konrad-bode/SummerSchool_25/SummerSchool_25.kicad_pcb

## KiCad design SummerSchool_25.kicad_pcb (2026-11-02)

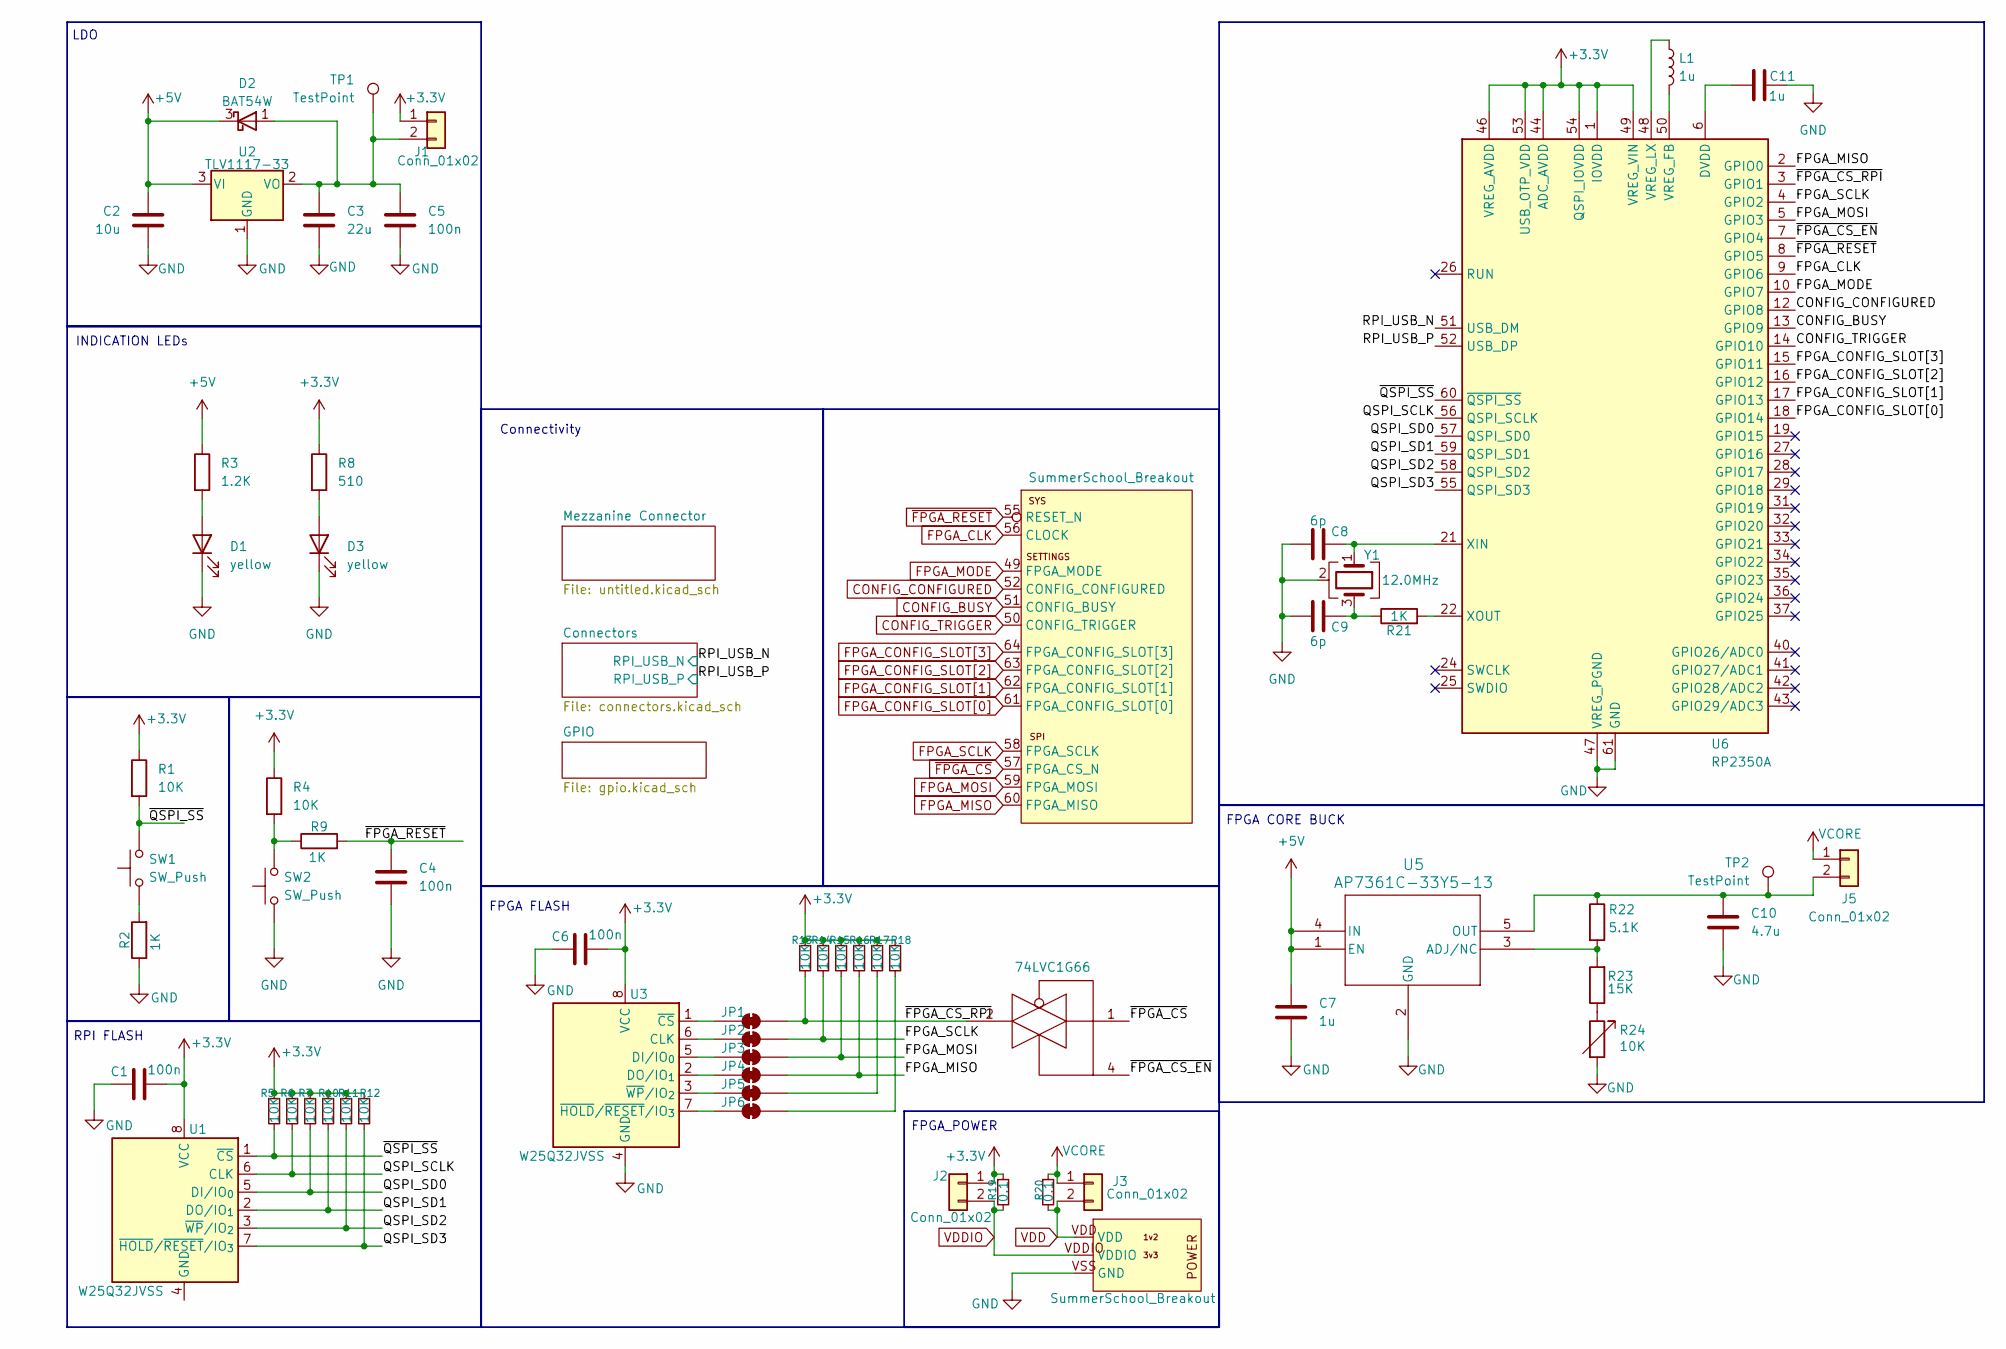
[picture p1: schematic SummerSchool_25.kicad_sch]

Parts:
C1, C4, C5, C6: 100n; C_0603_1608Metric
C2: 10u; C_0603_1608Metric
C3: 22u; C_0603_1608Metric
C7, C11: 1u; C_0603_1608Metric
C8, C9: 6p; C_0603_1608Metric
C10: 4.7u; C_0603_1608Metric
D1, D3: yellow; LED_0603_1608Metric
D2: BAT54W; SOT-323_SC-70
J1, J2, J3, J5: Conn_01x02; PinHeader_1x02_P2.54mm_Vertical
J4: SummerSchool_Breakout; SummerSchool_WireBond
JP1, JP2, JP3, JP4, JP5, JP6: SolderJumper_2_Bridged; SolderJumper-2_P1.3mm_Bridged2Bar_RoundedPad1.0x1.5mm
L1: 1u; L_1008_2520Metric
R1, R4, R5, R6, R7, R10, R11, R12, R13, R14, R15, R16, R17, R18: 10K; R_0603_1608Metric
R2, R9, R21: 1K; R_0603_1608Metric
R3: 1.2K; R_0603_1608Metric
R8: 510; R_0603_1608Metric
R19, R20: 0.1; R_0805_2012Metric
R22: 5.1K; R_0603_1608Metric
R23: 15K; R_0603_1608Metric
R24: 10K; R_LDR_5.2x5.2mm_P3.5mm_Horizontal
SW1, SW2: SW_Push; SW_SPST_EVQP2_MiddlePushTravel_H2.5mm
TP1, TP2: TestPoint; TestPoint_Pad_1.5x1.5mm
U1, U3: W25Q32JVSS; SOIC-8_5.3x5.3mm_P1.27mm
U2: TLV1117-33; TO-252-2
U4: 74LVC1G66; SOT-553
U5: AP7361C-33Y5-13; SOT89-5_DIO
U6: RP2350A; QFN-60-1EP_7x7mm_P0.4mm_EP3.4x3.4mm
Y1: 12.0MHz; Crystal_SMD_3225-4Pin_3.2x2.5mm

Connections:
+3.3V: C1.2, C6.2, J1.1, J2.1, R1.1, R4.1, R5.1, R6.1, R7.1, R8.1, R10.1, R11.1, R12.1, R13.1, R14.1, R15.1, R16.1, R17.1, R18.1, R19.1, U1.8 (VCC), U3.8 (VCC), U6.1 (IOVDD), U6.11 (IOVDD), U6.20 (IOVDD), U6.30 (IOVDD), U6.38 (IOVDD), U6.44 (ADC_AVDD), U6.45 (IOVDD), U6.46 (VREG_AVDD), U6.49 (VREG_VIN), U6.53 (USB_OTP_VDD), U6.54 (QSPI_IOVDD); also elsewhere on the board
+5V: C2.1, C7.1, D2.3 (K), R3.1, U2.3 (VI), U5.1 (EN), U5.4 (IN); also elsewhere on the board
/QSPI_SCLK: R6.2, U1.6 (CLK), U6.56 (QSPI_SCLK)
/QSPI_SD0: R7.2, U1.5 (DI/IO_{0}), U6.57 (QSPI_SD0)
/QSPI_SD1: R10.2, U1.2 (DO/IO_{1}), U6.59 (QSPI_SD1)
/QSPI_SD2: R11.2, U1.3 (~WP/IO_{2}), U6.58 (QSPI_SD2)
/QSPI_SD3: R12.2, U1.7 (~HOLD/~RESET/IO_{3}), U6.55 (QSPI_SD3)
/RPI_USB_N: U6.51 (USB_DM); also elsewhere on the board
/RPI_USB_P: U6.52 (USB_DP); also elsewhere on the board
/~FPGA_CS_EN: U4.4, U6.7 (GPIO4)
/~FPGA_CS_RPI: JP1.2 (B), R13.2, U4.2, U6.3 (GPIO1)
/~QSPI_SS: R1.2, R5.2, SW1.2, U1.1 (~CS), U6.60 (~QSPI_SS)
CONFIG_BUSY: U6.13 (GPIO9); also elsewhere on the board
CONFIG_CONFIGURED: U6.12 (GPIO8); also elsewhere on the board
CONFIG_TRIGGER: U6.14 (GPIO10); also elsewhere on the board
FPGA_CLK: U6.9 (GPIO6); also elsewhere on the board
FPGA_CONFIG_SLOT[0]: U6.18 (GPIO14); also elsewhere on the board
FPGA_CONFIG_SLOT[1]: U6.17 (GPIO13); also elsewhere on the board
FPGA_CONFIG_SLOT[2]: U6.16 (GPIO12); also elsewhere on the board
FPGA_CONFIG_SLOT[3]: U6.15 (GPIO11); also elsewhere on the board
FPGA_MISO: JP4.2 (B), R16.2, U6.2 (GPIO0); also elsewhere on the board
FPGA_MODE: U6.10 (GPIO7); also elsewhere on the board
FPGA_MOSI: JP3.2 (B), R15.2, U6.5 (GPIO3); also elsewhere on the board
FPGA_SCLK: JP2.2 (B), R14.2, U6.4 (GPIO2); also elsewhere on the board
GND: C1.1, C2.2, C3.2, C4.2, C5.2, C6.1, C7.2, C8.1, C9.1, C10.2, C11.2, D1.1 (K), D3.1 (K), J4.VSS (GND), R2.1, R24.2, SW2.1, U2.1 (GND), U3.4 (GND), U5.2 (GND), U6.47 (VREG_PGND), U6.61 (GND), Y1.2 (G), Y1.4 (G); also elsewhere on the board
unnamed: C9.2, R21.1, Y1.3
unnamed: C11.1, U6.6 (DVDD), U6.23 (DVDD), U6.39 (DVDD)
unnamed: D1.2 (A), R3.2
unnamed: C3.1, C5.1, D2.1 (A), J1.2, TP1.1 (1_1), U2.2 (VO)
unnamed: D3.2 (A), R8.2
unnamed: C10.1, J5.2, R22.1, TP2.1 (1_1), U5.5 (OUT)
unnamed: JP1.1 (A), U3.1 (~CS)
unnamed: JP2.1 (A), U3.6 (CLK)
unnamed: JP3.1 (A), U3.5 (DI/IO_{0})
unnamed: JP4.1 (A), U3.2 (DO/IO_{1})
unnamed: JP5.1 (A), U3.3 (~WP/IO_{2})
unnamed: JP5.2 (B), R17.2
unnamed: JP6.1 (A), U3.7 (~HOLD/~RESET/IO_{3})
unnamed: JP6.2 (B), R18.2
unnamed: R2.2, SW1.1
unnamed: R4.2, R9.1, SW2.2
unnamed: R23.1, R24.1
unnamed: R22.2, R23.2, U5.3 (ADJ/NC)
unnamed: L1.2, U6.50 (VREG_FB)
unnamed: L1.1, U6.48 (VREG_LX)
unnamed: C8.2, U6.21 (XIN), Y1.1
unnamed: R21.2, U6.22 (XOUT)
VCORE: J3.1, J5.1, R20.1
VDD: J3.2, J4.VDD, R20.2; also elsewhere on the board
VDDIO: J2.2, J4.VDDIO, R19.2; also elsewhere on the board
~FPGA_CS: U4.1; also elsewhere on the board
~FPGA_RESET: C4.1, R9.2, U6.8 (GPIO5); also elsewhere on the board

Notes on the sheet:
Connectivity
RPI FLASH
INDICATION LEDs
FPGA_POWER
FPGA CORE BUCK
FPGA FLASH
LDO

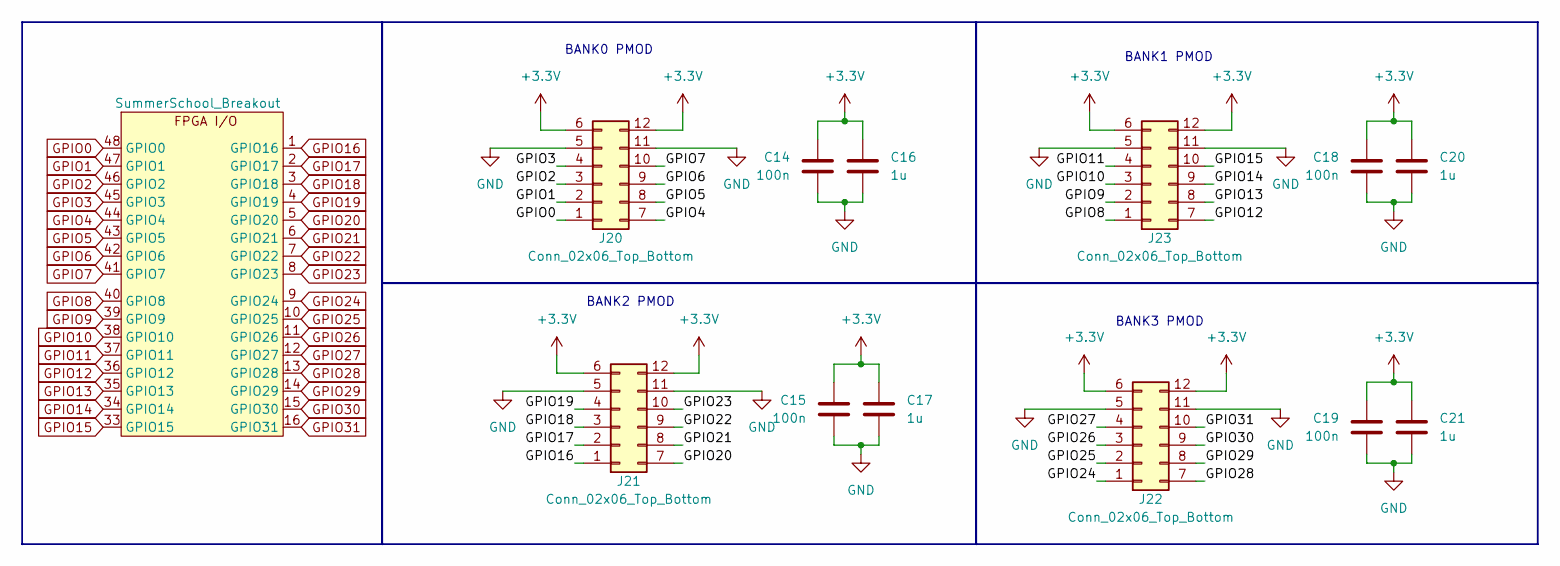
[picture p2: schematic gpio.kicad_sch]

Parts:
C14, C15, C18, C19: 100n; C_0603_1608Metric
C16, C17, C20, C21: 1u; C_0603_1608Metric
J4: SummerSchool_Breakout; SummerSchool_WireBond
J20, J21, J22, J23: Conn_02x06_Top_Bottom; PinSocket_2x06_P2.54mm_Horizontal

Connections:
+3.3V: C14.1, C15.1, C16.1, C17.1, C18.1, C19.1, C20.1, C21.1, J20.6, J20.12, J21.6, J21.12, J22.6, J22.12, J23.6, J23.12; also elsewhere on the board
GND: C14.2, C15.2, C16.2, C17.2, C18.2, C19.2, C20.2, C21.2, J20.5, J20.11, J21.5, J21.11, J22.5, J22.11, J23.5, J23.11; also elsewhere on the board
GPIO0: J20.1; also elsewhere on the board
GPIO1: J20.2; also elsewhere on the board
GPIO2: J20.3; also elsewhere on the board
GPIO3: J20.4; also elsewhere on the board
GPIO4: J20.7; also elsewhere on the board
GPIO5: J20.8; also elsewhere on the board
GPIO6: J20.9; also elsewhere on the board
GPIO7: J20.10; also elsewhere on the board
GPIO8: J23.1; also elsewhere on the board
GPIO9: J23.2; also elsewhere on the board
GPIO10: J23.3; also elsewhere on the board
GPIO11: J23.4; also elsewhere on the board
GPIO12: J23.7; also elsewhere on the board
GPIO13: J23.8; also elsewhere on the board
GPIO14: J23.9; also elsewhere on the board
GPIO15: J23.10; also elsewhere on the board
GPIO16: J21.1; also elsewhere on the board
GPIO17: J21.2; also elsewhere on the board
GPIO18: J21.3; also elsewhere on the board
GPIO19: J21.4; also elsewhere on the board
GPIO20: J21.7; also elsewhere on the board
GPIO21: J21.8; also elsewhere on the board
GPIO22: J21.9; also elsewhere on the board
GPIO23: J21.10; also elsewhere on the board
GPIO24: J22.1; also elsewhere on the board
GPIO25: J22.2; also elsewhere on the board
GPIO26: J22.3; also elsewhere on the board
GPIO27: J22.4; also elsewhere on the board
GPIO28: J22.7; also elsewhere on the board
GPIO29: J22.8; also elsewhere on the board
GPIO30: J22.9; also elsewhere on the board
GPIO31: J22.10; also elsewhere on the board

Notes on the sheet:
BANK1 PMOD
BANK3 PMOD
BANK2 PMOD
BANK0 PMOD

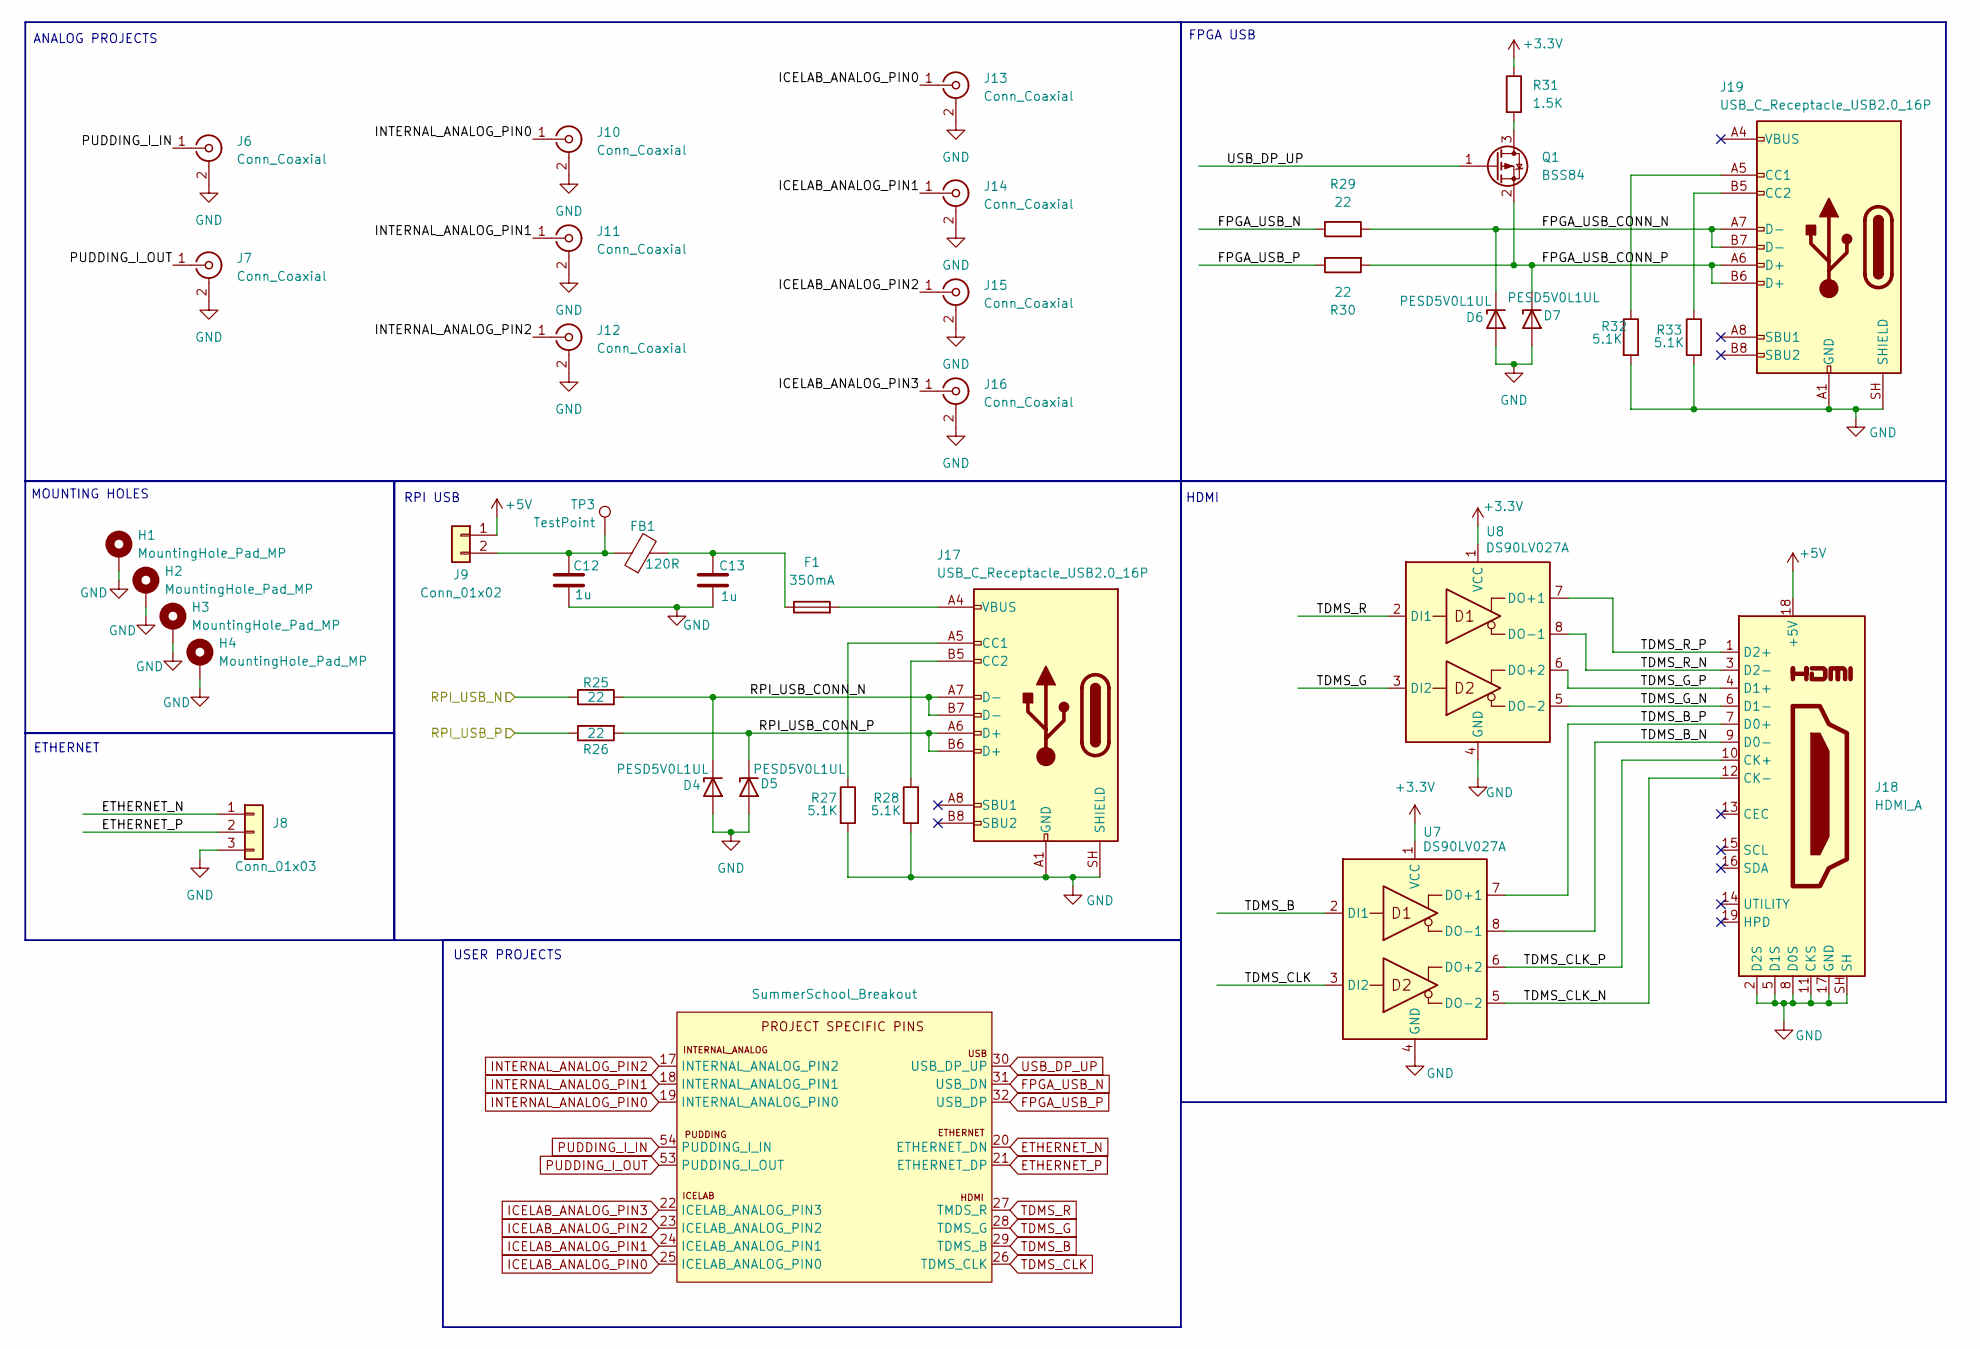
[picture p3: schematic connectors.kicad_sch]

Parts:
C12, C13: 1u; C_0603_1608Metric
D4, D5, D6, D7: PESD5V0L1UL; D_SOD-882
F1: 350mA; Fuse_0603_1608Metric
FB1: 120R; L_Eaton_MCL2012V1
H1, H2, H3, H4: MountingHole_Pad_MP; MountingHole_2.5mm_Pad_TopBottom
J4: SummerSchool_Breakout; SummerSchool_WireBond
J6, J7, J10, J11, J12, J13, J14, J15, J16: Conn_Coaxial; SMA_Amphenol_132134_Vertical
J8: Conn_01x03; FanPinHeader_1x03_P2.54mm_Vertical
J9: Conn_01x02; PinHeader_1x02_P2.54mm_Vertical
J17, J19: USB_C_Receptacle_USB2.0_16P; USB_C_Receptacle_XKB_U262-16XN-4BVC11
J18: HDMI_A; HDMI_A_Molex_208658-1001_Horizontal
Q1: BSS84; SOT-23
R25, R26, R29, R30: 22; R_0603_1608Metric
R27, R28, R32, R33: 5.1K; R_0603_1608Metric
R31: 1.5K; R_0603_1608Metric
TP3: TestPoint; TestPoint_Pad_1.5x1.5mm
U7, U8: DS90LV027A; SOIC-8_3.9x4.9mm_P1.27mm

Connections:
+3.3V: R31.1, U7.1 (VCC), U8.1 (VCC); also elsewhere on the board
+5V: J9.1, J18.18 (+5V); also elsewhere on the board
/Connectors/FPGA_USB_CONN_N: D6.1 (K), J19.A7 (D-), J19.B7 (D-), R29.2
/Connectors/FPGA_USB_CONN_P: D7.1 (K), J19.A6 (D+), J19.B6 (D+), Q1.2 (S), R30.2
/Connectors/RPI_USB_CONN_N: D4.1 (K), J17.A7 (D-), J17.B7 (D-), R25.2
/Connectors/RPI_USB_CONN_P: D5.1 (K), J17.A6 (D+), J17.B6 (D+), R26.2
/Connectors/TDMS_B_N: J18.9 (D0-), U7.8 (DO-1)
/Connectors/TDMS_B_P: J18.7 (D0+), U7.7 (DO+1)
/Connectors/TDMS_CLK_N: J18.12 (CK-), U7.5 (DO-2)
/Connectors/TDMS_CLK_P: J18.10 (CK+), U7.6 (DO+2)
/Connectors/TDMS_G_N: J18.6 (D1-), U8.5 (DO-2)
/Connectors/TDMS_G_P: J18.4 (D1+), U8.6 (DO+2)
/Connectors/TDMS_R_N: J18.3 (D2-), U8.8 (DO-1)
/Connectors/TDMS_R_P: J18.1 (D2+), U8.7 (DO+1)
/RPI_USB_N: R25.1; also elsewhere on the board
/RPI_USB_P: R26.1; also elsewhere on the board
ETHERNET_N: J8.1; also elsewhere on the board
ETHERNET_P: J8.2; also elsewhere on the board
FPGA_USB_N: R29.1; also elsewhere on the board
FPGA_USB_P: R30.1; also elsewhere on the board
GND: C12.2, C13.2, D4.2 (A), D5.2 (A), D6.2 (A), D7.2 (A), H1.1 (MP_1), H2.1 (MP_1), H3.1 (MP_1), H4.1 (MP_1), J6.2 (Ext), J7.2 (Ext), J8.3, J10.2 (Ext), J11.2 (Ext), J12.2 (Ext), J13.2 (Ext), J14.2 (Ext), J15.2 (Ext), J16.2 (Ext), J17.A1 (GND), J17.A12 (GND), J17.B1 (GND), J17.B12 (GND), J17.SH (SHIELD), J18.2 (D2S), J18.5 (D1S), J18.8 (D0S), J18.11 (CKS), J18.17 (GND), J18.SH, J19.A1 (GND), J19.A12 (GND), J19.B1 (GND), J19.B12 (GND), J19.SH (SHIELD), R27.2, R28.2, R32.2, R33.2, U7.4 (GND), U8.4 (GND); also elsewhere on the board
ICELAB_ANALOG_PIN0: J13.1 (In); also elsewhere on the board
ICELAB_ANALOG_PIN1: J14.1 (In); also elsewhere on the board
ICELAB_ANALOG_PIN2: J15.1 (In); also elsewhere on the board
ICELAB_ANALOG_PIN3: J16.1 (In); also elsewhere on the board
INTERNAL_ANALOG_PIN0: J10.1 (In); also elsewhere on the board
INTERNAL_ANALOG_PIN1: J11.1 (In); also elsewhere on the board
INTERNAL_ANALOG_PIN2: J12.1 (In); also elsewhere on the board
unnamed: C13.1, F1.1, FB1.2
unnamed: F1.2, J17.A4 (VBUS), J17.A9 (VBUS), J17.B4 (VBUS), J17.B9 (VBUS)
unnamed: C12.1, FB1.1, J9.2, TP3.1 (1_1)
unnamed: J17.A5 (CC1), R27.1
unnamed: J17.B5 (CC2), R28.1
unnamed: J19.A5 (CC1), R32.1
unnamed: J19.B5 (CC2), R33.1
unnamed: Q1.3 (D), R31.2
PUDDING_I_IN: J6.1 (In); also elsewhere on the board
PUDDING_I_OUT: J7.1 (In); also elsewhere on the board
TDMS_B: U7.2 (DI1); also elsewhere on the board
TDMS_CLK: U7.3 (DI2); also elsewhere on the board
TDMS_G: U8.3 (DI2); also elsewhere on the board
TDMS_R: U8.2 (DI1); also elsewhere on the board
USB_DP_UP: Q1.1 (G); also elsewhere on the board

Notes on the sheet:
ETHERNET
RPI USB
FPGA USB
HDMI
ANALOG PROJECTS
USER PROJECTS
MOUNTING HOLES

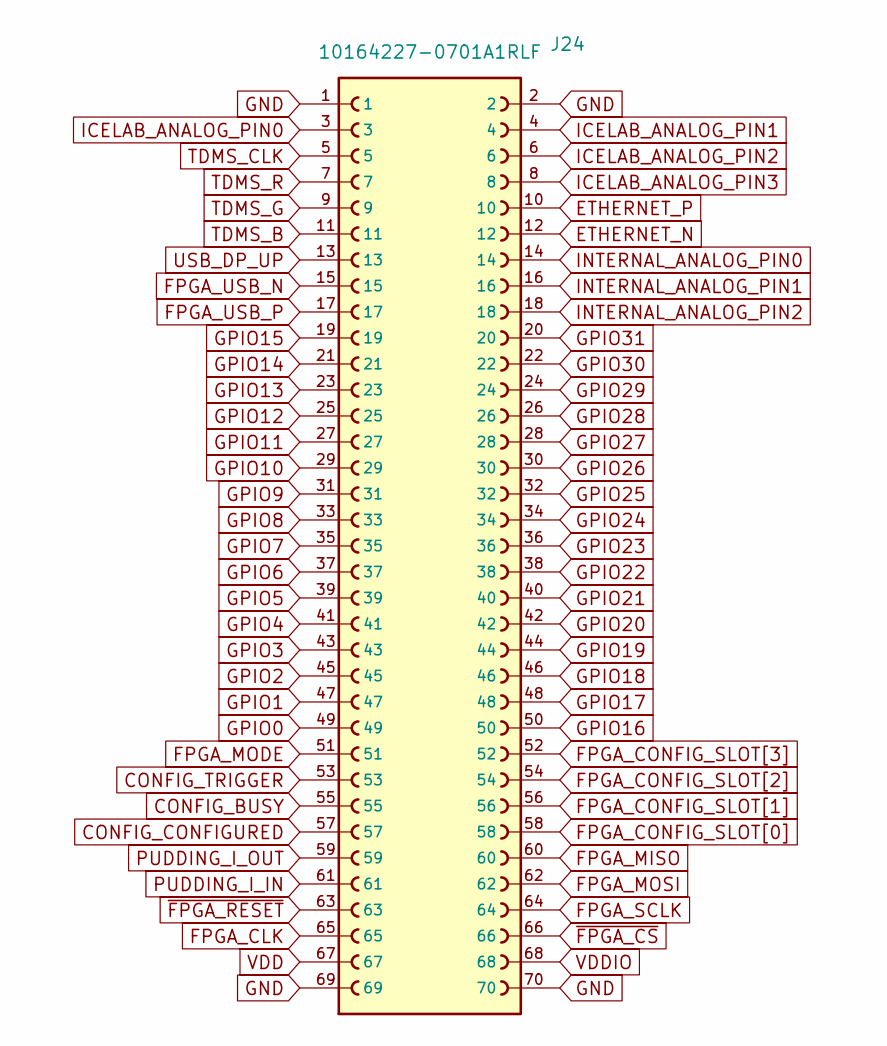
[picture p4: schematic untitled.kicad_sch]

Parts:
J24: 10164227-0701A1RLF; AMPHENOL_10164227-0701A1RLF; PARTREV C

Connections:
CONFIG_BUSY: J24.55; also elsewhere on the board
CONFIG_CONFIGURED: J24.57; also elsewhere on the board
CONFIG_TRIGGER: J24.53; also elsewhere on the board
ETHERNET_N: J24.12; also elsewhere on the board
ETHERNET_P: J24.10; also elsewhere on the board
FPGA_CLK: J24.65; also elsewhere on the board
FPGA_CONFIG_SLOT[0]: J24.58; also elsewhere on the board
FPGA_CONFIG_SLOT[1]: J24.56; also elsewhere on the board
FPGA_CONFIG_SLOT[2]: J24.54; also elsewhere on the board
FPGA_CONFIG_SLOT[3]: J24.52; also elsewhere on the board
FPGA_MISO: J24.60; also elsewhere on the board
FPGA_MODE: J24.51; also elsewhere on the board
FPGA_MOSI: J24.62; also elsewhere on the board
FPGA_SCLK: J24.64; also elsewhere on the board
FPGA_USB_N: J24.15; also elsewhere on the board
FPGA_USB_P: J24.17; also elsewhere on the board
GND: J24.1, J24.2, J24.69, J24.70; also elsewhere on the board
GPIO0: J24.49; also elsewhere on the board
GPIO1: J24.47; also elsewhere on the board
GPIO2: J24.45; also elsewhere on the board
GPIO3: J24.43; also elsewhere on the board
GPIO4: J24.41; also elsewhere on the board
GPIO5: J24.39; also elsewhere on the board
GPIO6: J24.37; also elsewhere on the board
GPIO7: J24.35; also elsewhere on the board
GPIO8: J24.33; also elsewhere on the board
GPIO9: J24.31; also elsewhere on the board
GPIO10: J24.29; also elsewhere on the board
GPIO11: J24.27; also elsewhere on the board
GPIO12: J24.25; also elsewhere on the board
GPIO13: J24.23; also elsewhere on the board
GPIO14: J24.21; also elsewhere on the board
GPIO15: J24.19; also elsewhere on the board
GPIO16: J24.50; also elsewhere on the board
GPIO17: J24.48; also elsewhere on the board
GPIO18: J24.46; also elsewhere on the board
GPIO19: J24.44; also elsewhere on the board
GPIO20: J24.42; also elsewhere on the board
GPIO21: J24.40; also elsewhere on the board
GPIO22: J24.38; also elsewhere on the board
GPIO23: J24.36; also elsewhere on the board
GPIO24: J24.34; also elsewhere on the board
GPIO25: J24.32; also elsewhere on the board
GPIO26: J24.30; also elsewhere on the board
GPIO27: J24.28; also elsewhere on the board
GPIO28: J24.26; also elsewhere on the board
GPIO29: J24.24; also elsewhere on the board
GPIO30: J24.22; also elsewhere on the board
GPIO31: J24.20; also elsewhere on the board
ICELAB_ANALOG_PIN0: J24.3; also elsewhere on the board
ICELAB_ANALOG_PIN1: J24.4; also elsewhere on the board
ICELAB_ANALOG_PIN2: J24.6; also elsewhere on the board
ICELAB_ANALOG_PIN3: J24.8; also elsewhere on the board
INTERNAL_ANALOG_PIN0: J24.14; also elsewhere on the board
INTERNAL_ANALOG_PIN1: J24.16; also elsewhere on the board
INTERNAL_ANALOG_PIN2: J24.18; also elsewhere on the board
PUDDING_I_IN: J24.61; also elsewhere on the board
PUDDING_I_OUT: J24.59; also elsewhere on the board
TDMS_B: J24.11; also elsewhere on the board
TDMS_CLK: J24.5; also elsewhere on the board
TDMS_G: J24.9; also elsewhere on the board
TDMS_R: J24.7; also elsewhere on the board
USB_DP_UP: J24.13; also elsewhere on the board
VDD: J24.67; also elsewhere on the board
VDDIO: J24.68; also elsewhere on the board
~FPGA_CS: J24.66; also elsewhere on the board
~FPGA_RESET: J24.63; also elsewhere on the board

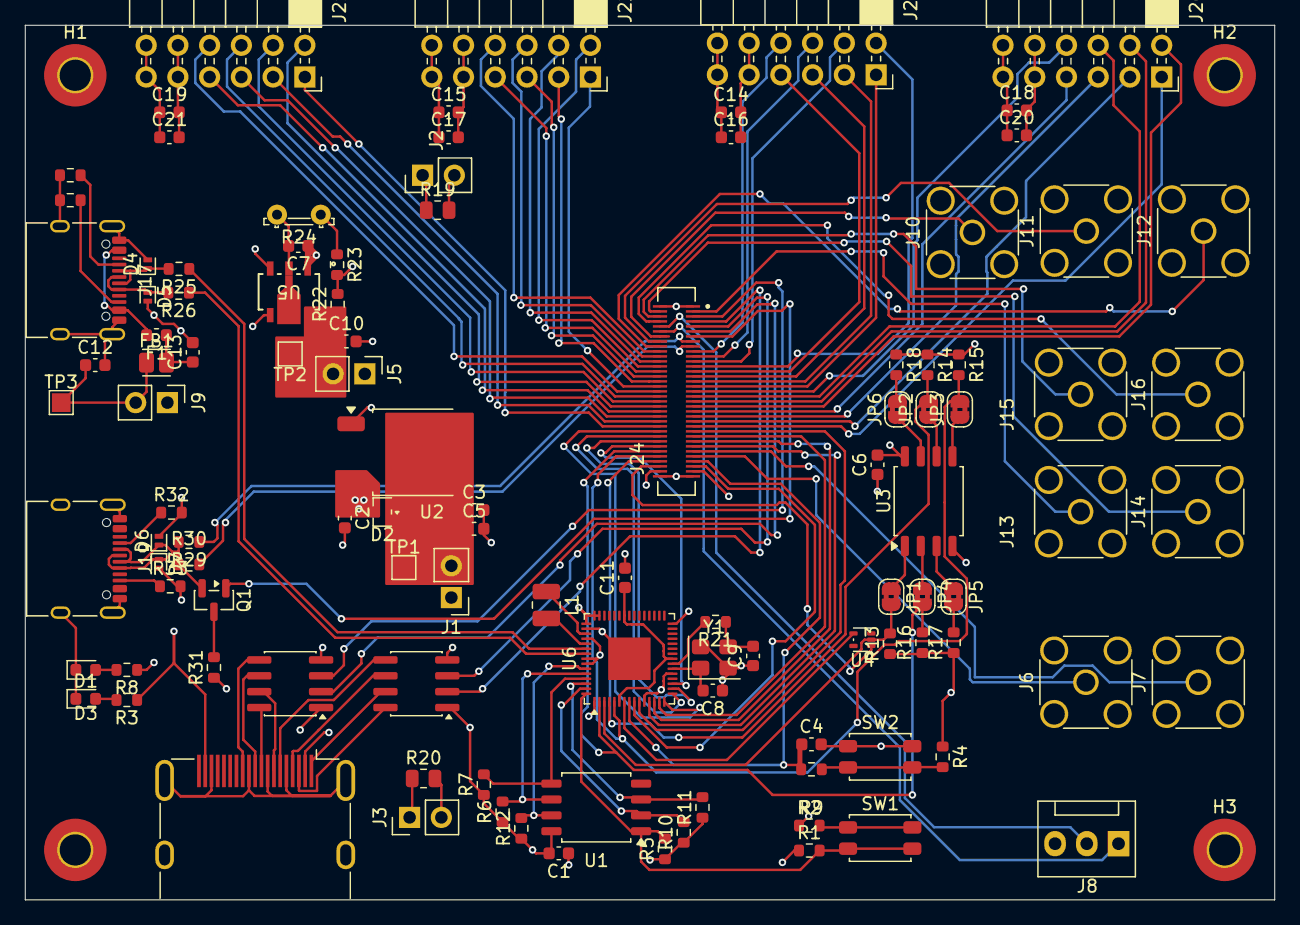
[picture p5: board SummerSchool_25.kicad_pcb from above]

Board: 4 copper layers, 100.0 x 70.0 mm, 112 parts (0 on the bottom side), 122 nets.
